leeiozh/SWIM/README.md

# SWIM — пакет передачи проекта

SWIM (Shipborne Wave and Inertial Monitor) — прототип автономного регистратора
волнения на LilyGO T-Display-S3. Прошивка автоматически поддерживает два
собранных прибора: ICM-42688-P на GPIO1/2 и BMI323/GY-601N1 на GPIO21/16.
Она оценивает `Hs`, `Tp`, `Tm02` и направление волн, добавляет координаты и UTC
от NEO-M8N и пишет минутные записи на microSD, а при её отсутствии — во
внутренний FFat.

> Текущий статус: Hs уверенно повторяет изменчивость эталонов, но завышен
> примерно на 0,5–0,6 м. Tp и направление пока не валидированы и не должны
> использоваться как абсолютные измерения. Подробности — в
> [отчёте по первым данным](docs/05-first-data-report.md).

## С чего начать новому участнику

1. Прочитать [краткий паспорт и запуск](docs/01-instrument-and-quickstart.md).
2. Собрать прибор строго по [схеме подключения](docs/02-wiring.md).
3. Пройти [полевой и аналитический пайплайн](docs/03-pipeline.md).
4. Понять ограничения реализации по [описанию алгоритма](docs/04-algorithm.md).
5. Перед изменениями просмотреть [журнал ошибок и решений](docs/06-lessons-learned.md).
6. Для расшифровки бинарников использовать [описание формата v3](docs/07-log-format.md).

## Карта каталогов

```text
SWIM/
├── SWIM.ino                 точка входа и планировщик прошивки
├── SWIMConfig.h             источник истины: пины, частоты, окна, пороги
├── SwimTypes.h              структуры данных
├── {ImuSensor,GnssReceiver,WaveAnalyzer,
│    DataLogger,DisplayUi,WifiPortal}.{h,cpp}
│                            модули основной прошивки
├── GPS_debug/               ранний диагностический GNSS-скетч
├── GPS_rx_test/             тест приёма UART GNSS
├── GPS_uart_probe/          поиск/проверка UART GNSS
├── I2C_debug/               сканер и диагностика I2C
├── IMU_debug/               отдельная проверка и калибровка IMU
├── IMU_orientation_calibration/ шестипозиционная калибровка IMU
├── tools/                   конвертация, QC, внешняя валидация, графики, PDF
├── logs/                    исходные CSV-экспорты (включая повторы)
├── analysis/                ранний разбор наземных тестов
├── outputs/swim_report/     очищенные таблицы, метрики, рисунки, внешние данные
├── output/pdf/              итоговый PDF-отчёт
├── docs/                    документация передачи и исторический контекст
└── tmp/                     временный рендер PDF; можно пересоздать
```

Исходники лежат в корне намеренно: это папка Arduino-скетча `SWIM`, и Arduino
IDE собирает соседние `.ino/.cpp/.h` вместе. Не переносить их по отдельности.

## Быстрая сборка

Проверенная конфигурация текущего кода:

```text
Board:             ESP32S3 Dev Module
ESP32 core:        2.0.14
USB CDC On Boot:   Enabled
Flash Size:        16 MB
Partition Scheme:  16M Flash (3MB APP/9.9MB FATFS)
PSRAM:             OPI PSRAM
Arduino_GFX:       1.6.1
```

1. Открыть `SWIM.ino` в Arduino IDE.
2. Выбрать параметры выше и загрузить прошивку.
3. При старте убедиться, что нет `PSRAM ERROR` или `IMU ERROR`, а строка
   `Storage backend` показывает `microSD` либо `FFat`.
4. Тройным коротким нажатием правой кнопки выполнить `SET ZERO`, удерживая
   прибор неподвижно в штатном вертикальном положении.
5. Дождаться первого расчёта и проверить появление имени журнала.

При отсутствии microSD автоматически используется FFat. Если не монтируется и
он, проверить схему разделов `3MB APP/9.9MB FATFS`; полное стирание flash
допустимо только осознанно, поскольку удаляет внутренние журналы и NVS.

## Управление

- Левая кнопка: страницы `GNSS → WAVES → SPECTRUM → SAVE`.
- Правая, одно короткое нажатие: `MARK`; на `SPECTRUM` меняет вид; на `SAVE`
  включает/выключает Wi-Fi.
- Правая, три коротких нажатия: `SET ZERO`.
- Правая, удержание ≥3 с на `SAVE`: переключение `TEST/FIELD` и перезапуск.
- Wi-Fi: сеть `SWIM`, пароль `swimswim`, адрес `http://192.168.4.1/`.

`TEST`: 4096 отсчётов (~81,92 с), расчёт каждые 20 с. `FIELD`: 30 000
отсчётов (10 мин), расчёт каждую минуту. Постоянно пишутся только минутные
summary; сырые 50-Гц ряды остаются в кольцевом буфере PSRAM.

Хранилище выбирается при каждом запуске: исправная microSD имеет приоритет;
если карты нет, используются примерно 9,9 MB внутреннего FFat. Формат файлов
одинаков (`SWIMLOG` v3), а Wi-Fi показывает файлы активного backend.

## Главные артефакты

- Готовый отчёт: `output/pdf/SWIM_validation_report_2026-08-25_09-01.pdf`.
- Машиночитаемые метрики: `outputs/swim_report/analysis_summary.json`.
- Очищенные данные с QC: `outputs/swim_report/swim_marine_deduplicated_qc.csv`.
- Исторический контекст (может содержать устаревшие планы):
  `docs/project-context.md`.
